loicdrbx/Hydroponics_Kicad/Hydroponics Shield/Hydroponics Shield Rev4/hydroponics_shield_rev4.step

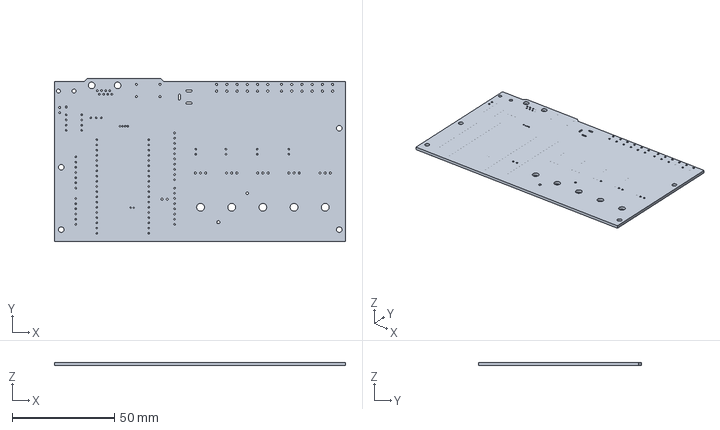
[picture p1: CAD file, 2019-01-07]
Hydroponics Shield/Hydroponics Shield Rev4/hydroponics_shield_rev4.step
142.2 x 79.8 x 1.60 mm
