loicdrbx/Hydroponics_Kicad/Hydroponics Shield/Hydroponics Shield Rev4/hydroponics_shield_rev4.kicad_pcb

## KiCad design Hydroponics Shield/Hydroponics Shield Rev4/hydroponics_shield_rev4.kicad_pcb (2019-01-07)

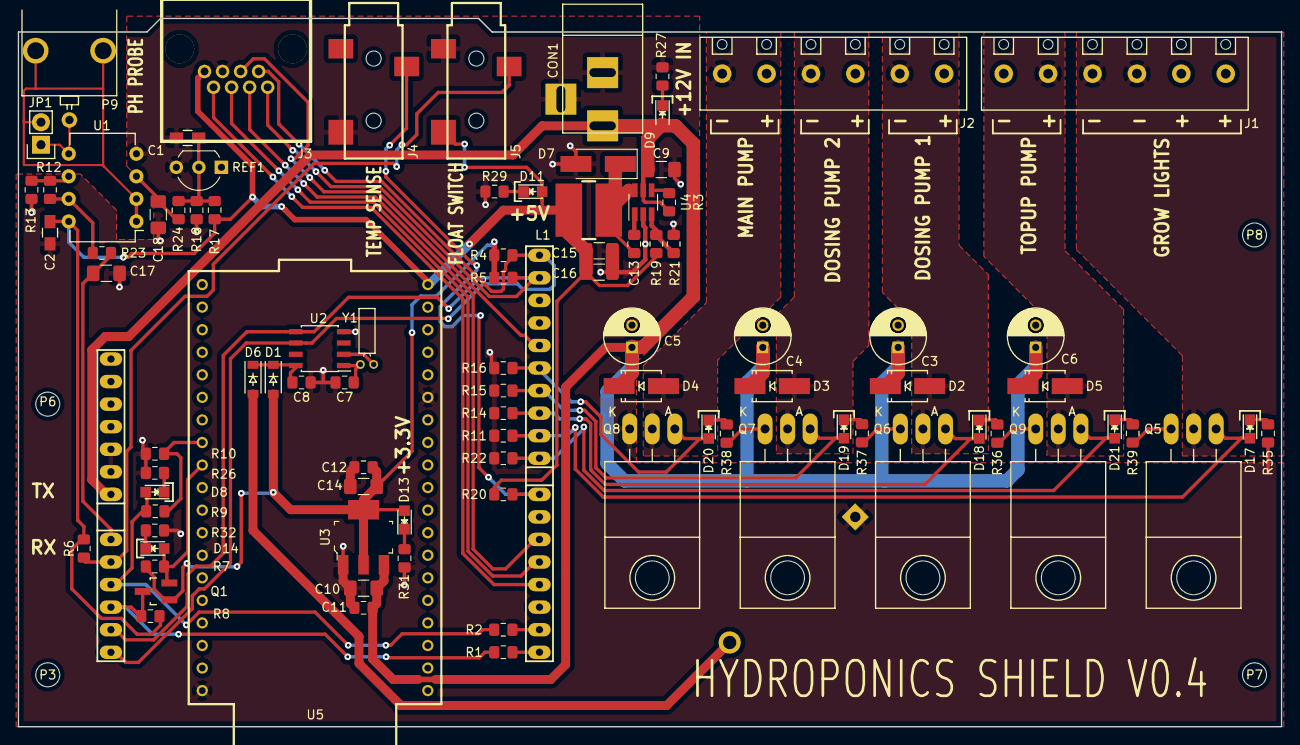
[picture p2: board hydroponics_shield_rev4.kicad_pcb from above]

Board: 2 copper layers, 142.2 x 79.8 mm, 97 parts (1 on the bottom side), 53 nets.

Parts:
BAT1: BS-7_2032; BS-7_USER
C1, C2: 0.1uF; C_0805_HandSoldering
C3, C4, C5, C6: 5ZLH100MEFC6.3X11; C_Radial_D6.3_L11.2_P2.5
C7: 12.5pF NP0; C_0805_2012Metric_Pad1.15x1.40mm_HandSolder
C8, C11, C12: 0.1uF; C_0805_2012Metric_Pad1.15x1.40mm_HandSolder
C9, C10, C14, C15, C16, C17, C18: 4.7uF; C_1206_3216Metric_Pad1.42x1.75mm_HandSolder
C13: 10nF; C_0805_2012Metric_Pad1.15x1.40mm_HandSolder
CON1: PJ-202A; BARREL_JACK
D1, D6: 1N4448W-TP; SOD-123
D2, D3, D4, D5: S1GTR; SMA_Handsoldering
D7: STPS160A; D_SMA_Handsoldering
D8, D9, D11, D13, D14, D17, D18, D19, D20, D21: GN; LED_0805
J1, J2: 282836-6
J3: RJHSE-5080
J4, J5: SJ-3523-SMT-TR
JP1: Jumper_NO_Small; Pin_Header_Straight_1x02
L1: SRN6045-101; SRN6045
P3, P6, P7, P8: MTG; MountingHole_2-7mm
P9: 0731000105
Q1: DMN65D8L-7; SOT-23_Handsoldering
Q5, Q6, Q7, Q8, Q9: PSMN022-30PL,127; TO-220_Neutral123_Horizontal_LargePads
R1, R12: 0; R_0805_2012Metric_Pad1.15x1.40mm_HandSolder
R2, R13, R18: DNP; R_0805_2012Metric_Pad1.15x1.40mm_HandSolder
R3, R7, R8, R9, R10, R11, R14, R15, R16, R20, R22: 10.0k; R_0805_2012Metric_Pad1.15x1.40mm_HandSolder
R4, R5, R27: 1.0k; R_0805_2012Metric_Pad1.15x1.40mm_HandSolder
R6: 4.7k; R_0805_2012Metric_Pad1.15x1.40mm_HandSolder
R17: 10.0k 0.1%; R_0805_2012Metric_Pad1.15x1.40mm_HandSolder
R19, R23, R24: 49.9k; R_0805_2012Metric_Pad1.15x1.40mm_HandSolder
R21: 9.53k; R_0805_2012Metric_Pad1.15x1.40mm_HandSolder
R26, R29, R35, R36, R37, R38, R39: 500; R_0805_2012Metric_Pad1.15x1.40mm_HandSolder
R31, R32: 200; R_0805_2012Metric_Pad1.15x1.40mm_HandSolder
REF1: LT1004CZ-2.5; TO-92_Inline_Wide
SHIELD1: ARDUINO_SHIELD_R3_WI2C
U1: LMC6482IN; DIP-8_W7.62mm
U2: PCF8563T; SOIC-8_3.9x4.9mm_P1.27mm
U3: AZ1117CH-3_3TRG1; SOT-223
U4: AOZ1280CI; SOT-23-6_Handsoldering
U5: ESP32_devkitc; ESP32_DEVKITC
Y1: CFS-20632768DZFB; Crystal_Round_Horizontal_2mm

Connections:
+3V3: C12.1, C14.1, D1.2, D13.2, Q1.1, R4.2, R5.2, R7.2, U3.2, U3.4
+5V: C2.1, C15.1, C16.1, D11.2, J3.1, J5.2, L1.1, R6.2, R8.1, R17.1, R19.2, R20.2, U1.8, U5.5V
+12V: C3.1, C4.1, C5.1, C6.1, C9.1, C10.1, C11.1, CON1.1, D2.1, D3.1, D4.1, D5.1, D9.2, J1.1, J1.2, J1.6, J2.1, J2.3, J2.5, R3.2, SHIELD1.V_IN, U3.3, U4.5
/D1DRV: D2.2, J2.2, Q6.2
/D2DRV: D3.2, J2.4, Q7.2
/LEDDRV: J1.3, J1.4, Q5.2
/MPDRV: D4.2, J2.6, Q8.2
/TPDRV: D5.2, J1.5, Q9.2
BATT_BACKUP: BAT1.2, D6.2
DISPLAY_RESET: J3.5, SHIELD1.13
DOSING_PUMP_1: D18.2, Q6.1, R14.2, SHIELD1.10
DOSING_PUMP_2: D19.2, Q7.1, R15.2, SHIELD1.11
ENCODER_A: J3.2, SHIELD1.3
ENCODER_B: J3.4, SHIELD1.4
ENCODER_SW: J3.6, SHIELD1.5
FLOAT_SWITCH_IN: J4.3, R20.1, SHIELD1.7
GND: BAT1.1, C1.2, C2.2, C3.2, C4.2, C5.2, C6.2, C7.2, C8.1, C9.2, C10.2, C11.2, C12.2, C14.2, C15.2, C16.2, C17.2, C18.2, CON1.2, CON1.3, D7.2, J3.3, J4.2, J5.1, Q5.3, Q6.3, Q7.3, Q8.3, Q9.3, R10.1, R11.1, R13.1, R14.1, R15.1, R16.1, R18.2, R21.1, R22.1, R26.2, R27.2, R29.2, R31.2, R32.2, R35.2, R36.2, R37.2, R38.2, R39.2, REF1.3, SHIELD1.GND1, SHIELD1.GND2, SHIELD1.GND3, U1.4, U2.4, U3.1, U4.2, U5.GND1, U5.GND2, U5.GND3
LED_STRIP_OUT: D17.2, Q5.1, R11.2, SHIELD1.9
MAIN_PUMP: D20.2, Q8.1, R16.2, SHIELD1.12
unnamed: C1.1, R17.2, R18.1, R24.1, REF1.2
unnamed: C7.1, U2.1, Y1.1
unnamed: C8.2, D1.1, D6.1, U2.8
unnamed: C13.1, U4.1
unnamed: C13.2, D7.1, L1.2, U4.6
unnamed: C18.1, R24.2, U1.3
unnamed: D8.1, R26.1
unnamed: D9.1, R27.1
unnamed: D11.1, R29.1
unnamed: D13.1, R31.1
unnamed: D14.1, R32.1
unnamed: D14.2, Q1.2, R7.1, U5.17
unnamed: D17.1, R35.1
unnamed: D18.1, R36.1
unnamed: D19.1, R37.1
unnamed: D20.1, R38.1
unnamed: D21.1, R39.1
unnamed: JP1.1, P9.1, U1.5
unnamed: R1.2, SHIELD1.0
unnamed: R2.2, SHIELD1.1
unnamed: R3.1, U4.4
unnamed: R9.1, R10.2, U5.16
unnamed: R12.1, R13.2, U1.6
unnamed: R12.2, R23.2, U1.7
unnamed: R19.1, R21.2, U4.3
unnamed: U2.2, Y1.2
PH_VOUT: C17.1, R23.1, SHIELD1.AD0
SCL: J3.7, R4.1, SHIELD1.AD5, SHIELD1.SCL, U2.6
SDA: J3.8, R5.1, SHIELD1.AD4, SHIELD1.SDA, U2.5
TEMP_SENSE_IN: J5.3, R6.1, SHIELD1.AD1
TOPUP_PUMP: D21.2, Q9.1, R22.2, SHIELD1.8
Vguard: JP1.2, P9.2, P9.3, U1.1, U1.2
WIFI_DATA_RECEIVE: Q1.3, R1.1, R8.2, SHIELD1.AD3
WIFI_DATA_TRANSMIT: D8.2, R2.1, R9.2, SHIELD1.AD2
