loicdrbx/Hydroponics_Kicad/Controller Board/Controller Board Rev2/controller_board.kicad_pcb

## KiCad design Controller Board/Controller Board Rev2/controller_board.kicad_pcb (2019-01-07)

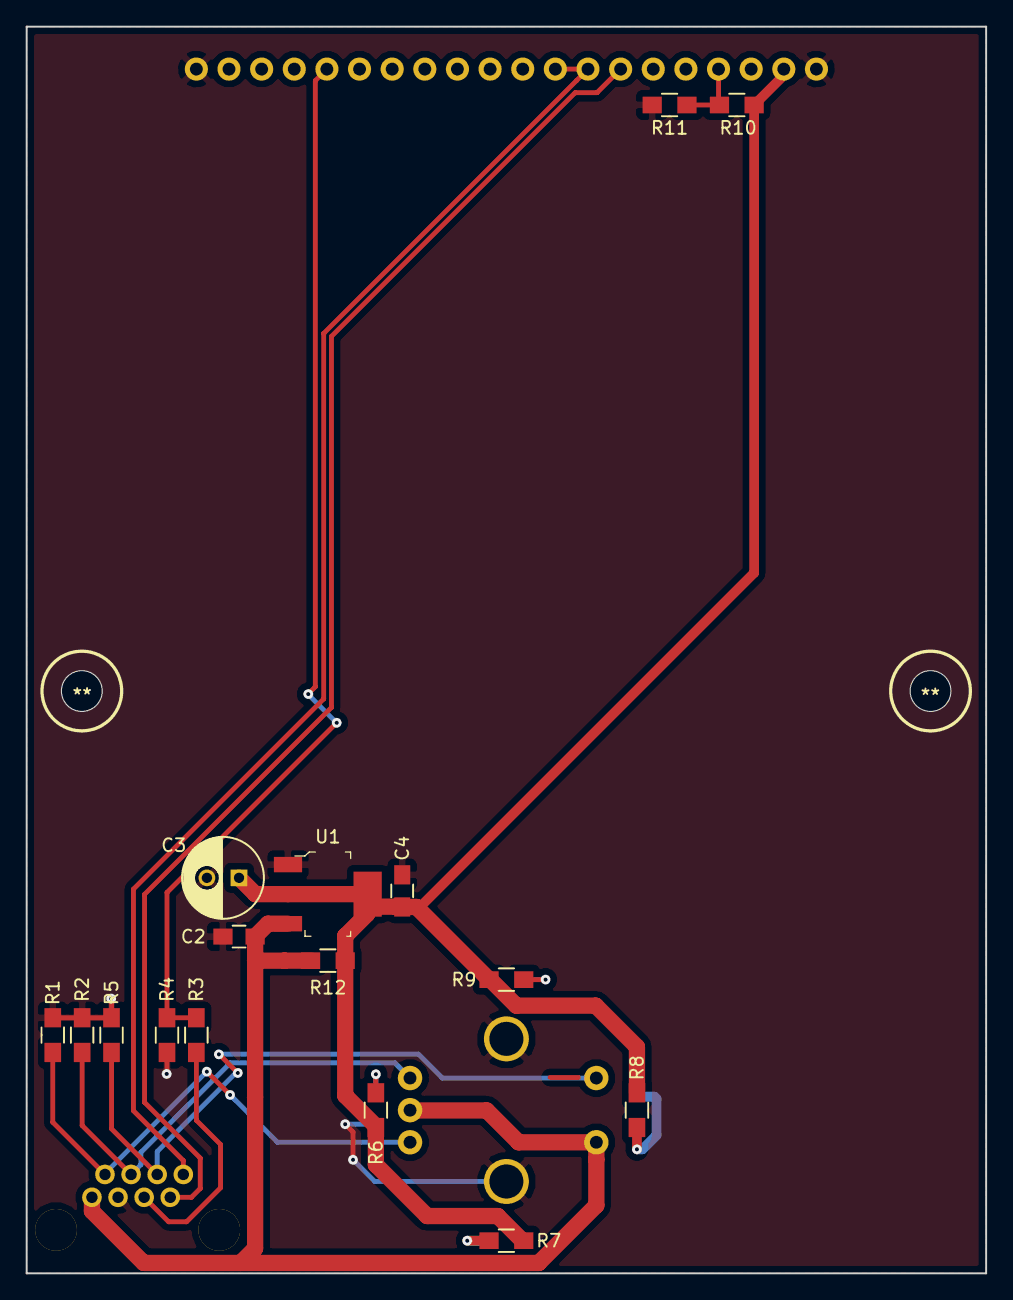
[picture p3: board controller_board.kicad_pcb from above]

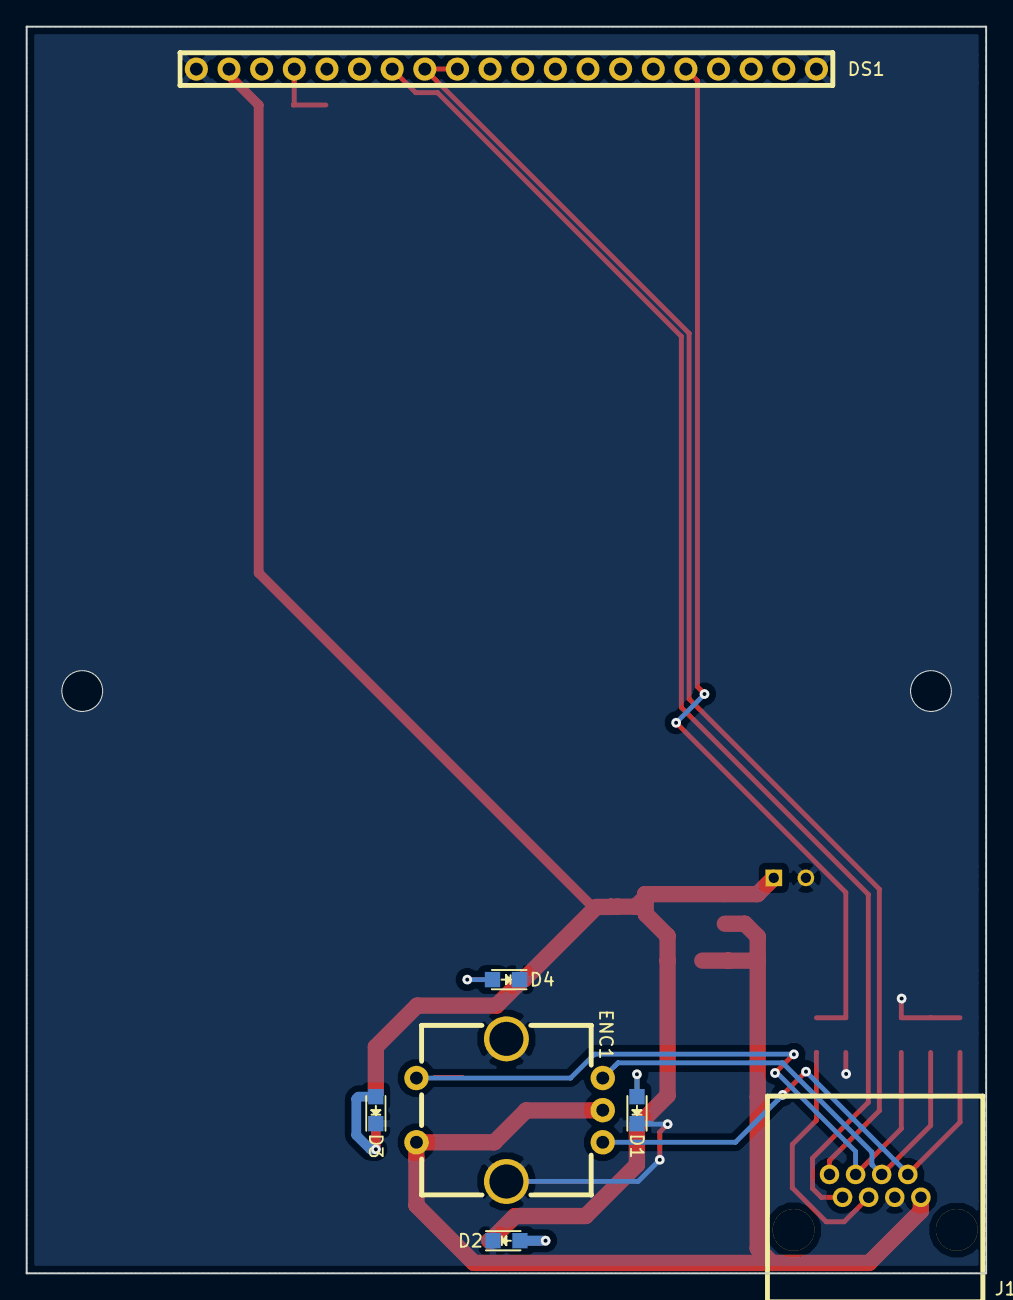
[picture p4: board controller_board.kicad_pcb from below]

Board: 2 copper layers, 74.7 x 97.0 mm, 25 parts (7 on the bottom side), 15 nets.

Parts:
**: MOUNTING_HOLE_0.125in
**#2: MOUNTING_HOLE_0.125in
C2, C4: 0.1uF; C_0805_HandSoldering
C3: 5ZLH100MEFC6.3X11; C_Radial_D6.3_L11.2_P2.5
D1, D2, D3, D4: GRN; LED_0805
DS1: OLED_GENERIC_SSD1305_20PIN_128x64; 128x64_OLED_20PIN_HORIZONTAL
ENC1: EC11K1524406
J1: RJHSE-5080
R1, R2, R3, R4, R5: 10.0k; R_0805_HandSoldering
R6, R7, R8, R9: 120; R_0805_HandSoldering
R10: 0; R_0805_HandSoldering
R11, R12: DNP; R_0805_HandSoldering
U1: AZ1117CH-3_3TRG1; SOT-223

Connections:
+3V3: C3.1, C4.1, DS1.2, R6.1, R7.1, R8.1, R9.1, R10.1, R12.1, U1.2, U1.4
ENCODER_A: ENC1.A, J1.2, R1.1
ENCODER_B: ENC1.B, J1.4, R2.1
ENCODER_SW: ENC1.E, J1.6, R5.1
GND: C2.2, C3.2, C4.2, D1.1, D2.1, D3.1, D4.1, DS1.1, DS1.20, ENC1.MTG1, ENC1.MTG2, J1.3, R1.2, R2.2, R4.2, R5.2, R11.2, U1.1
unnamed: D1.2, R6.2
unnamed: D2.2, R7.2
unnamed: D3.2, R8.2
unnamed: D4.2, R9.2
unnamed: DS1.4, R10.2, R11.1
unnamed: J1.5, R3.1
OLED_RESET: DS1.16, R3.2, R4.1
SCL: DS1.7, J1.7
SDA: DS1.8, DS1.9, J1.8
VCC: C2.1, ENC1.C, ENC1.D, J1.1, R12.2, U1.3
