loicdrbx/Hydroponics_Kicad/Hydroponics Shield/Hydroponics Shield Rev1/hydroponics_shield_rev1.kicad_pcb

## KiCad design Hydroponics Shield/Hydroponics Shield Rev1/hydroponics_shield_rev1.kicad_pcb (2018-05-15, an earlier design)

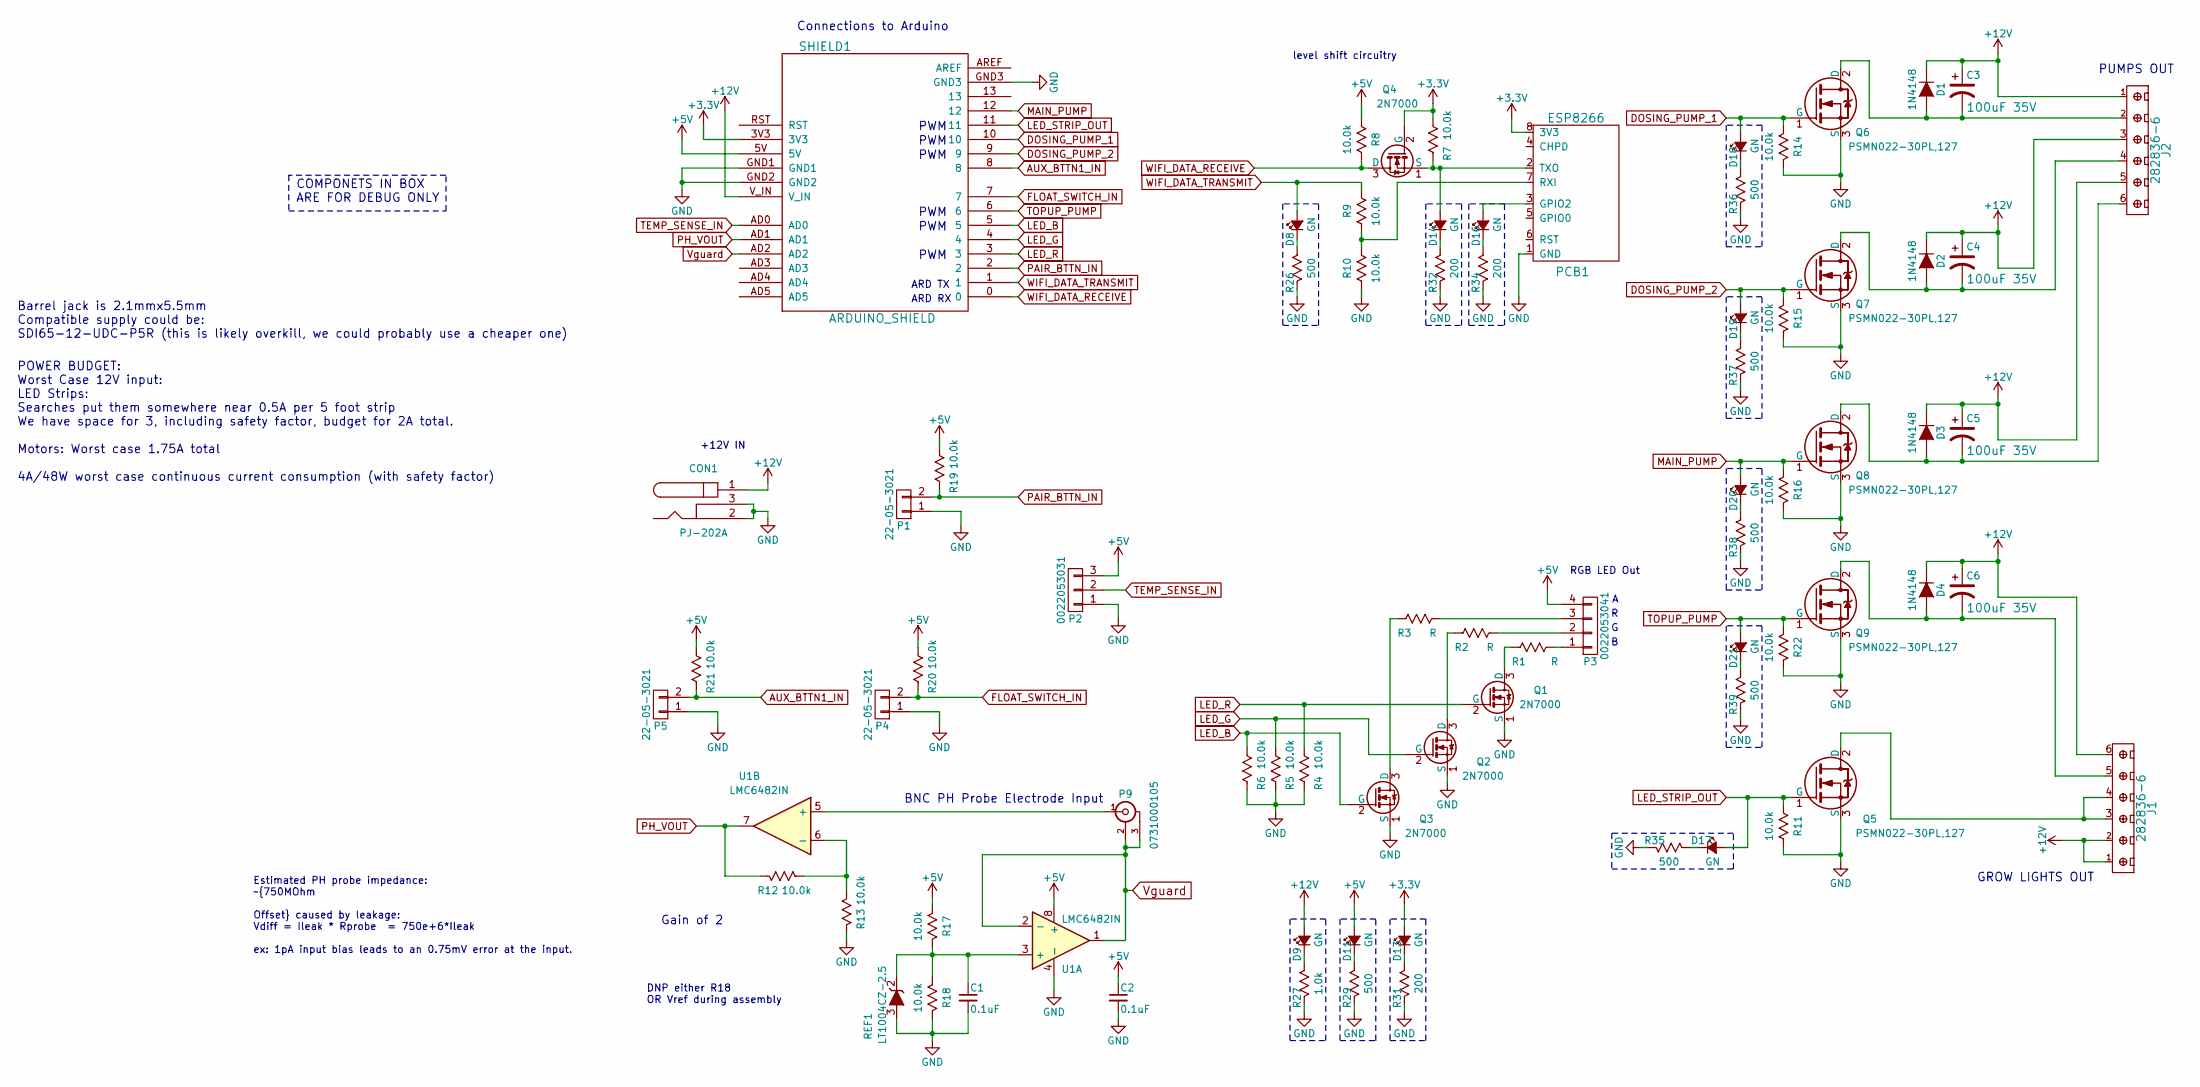
[picture p5: schematic hydroponics_shield_rev1.sch]

Parts:
C1, C2: 0.1uF; C_Disc_D7.5_P5
C3, C4, C5, C6: 5ZLH100MEFC6.3X11; C_Radial_D6.3_L11.2_P2.5
CON1: PJ-202A; BARREL_JACK
D1, D2, D3, D4: 1N4148; Diode_DO-35_SOD27_Horizontal_RM10
D8, D9, D11, D13, D14, D16, D17, D18, D19, D20, D21: GN; LED_0805
J1, J2: 282836-6
P1, P4, P5: 22-05-3021; Pin_Header_Angled_1x02
P2: 0022053031; Pin_Header_Angled_1x03
P3: 0022053041; Pin_Header_Angled_1x04
P9: 0731000105
PCB1: ESP8266
Q1, Q2, Q3, Q4: 2N7000; TO-92_Inline_Wide
Q5, Q6, Q7, Q8, Q9: PSMN022-30PL,127; TO-220_Neutral123_Horizontal_LargePads
R1, R2, R3: R; Resistor_Horizontal_RM10mm
R4, R5, R6, R7, R8, R9, R10, R11, R12, R13, R14, R15, R16, R17, R18, R19, R20, R21, R22: 10.0k; Resistor_Horizontal_RM10mm
R26, R29, R35, R36, R37, R38, R39: 500; R_0805_HandSoldering
R27: 1.0k; R_0805_HandSoldering
R31, R32, R34: 200; R_0805_HandSoldering
REF1: LT1004CZ-2.5; TO-92_Inline_Wide
SHIELD1: ARDUINO_SHIELD; ARDUINO_SHIELD_NOSILK
U1: LMC6482IN; DIP-8_W7.62mm

Connections:
+3V3: D13.2 (A), PCB1.8 (3V3), Q4.2 (G), R7.2, SHIELD1.3V3
+5V: C2.1, D11.2 (A), P2.3, P3.4, R8.1, R17.1, R19.2, R20.2, R21.2, SHIELD1.5V, U1.8 (+)
+12V: C3.1, C4.1, C5.1, C6.1, CON1.1, D1.1 (K), D2.1 (K), D3.1 (K), D4.1 (K), D9.2 (A), J1.1, J1.2, J1.6, J2.1, J2.3, J2.5, SHIELD1.V_IN
AUX_BTTN1_IN: P5.2, R21.1, SHIELD1.8
DOSING_PUMP_1: D18.2 (A), Q6.1 (G), R14.2, SHIELD1.10
DOSING_PUMP_2: D19.2 (A), Q7.1 (G), R15.2, SHIELD1.9
FLOAT_SWITCH_IN: P4.2, R20.1, SHIELD1.7
GND: C1.2, C2.2, CON1.2, CON1.3, P1.1, P2.1, P4.1, P5.1, PCB1.1 (GND), Q1.1 (S), Q2.1 (S), Q3.1 (S), Q5.3 (S), Q6.3 (S), Q7.3 (S), Q8.3 (S), Q9.3 (S), R4.1, R5.1, R6.1, R10.1, R11.1, R13.1, R14.1, R15.1, R16.1, R18.2, R22.1, R26.2, R27.2, R29.2, R31.2, R32.2, R34.2, R35.2, R36.2, R37.2, R38.2, R39.2, REF1.3, SHIELD1.GND1, SHIELD1.GND2, SHIELD1.GND3, U1.4 (-)
LED_B: Q3.2 (G), R6.2, SHIELD1.5
LED_G: Q2.2 (G), R5.2, SHIELD1.4
LED_R: Q1.2 (G), R4.2, SHIELD1.3
LED_STRIP_OUT: D17.2 (A), Q5.1 (G), R11.2, SHIELD1.11
MAIN_PUMP: D20.2 (A), Q8.1 (G), R16.2, SHIELD1.12
unnamed: C1.1, R17.2, R18.1, REF1.2, U1.3 (+)
unnamed: C3.2, D1.2 (A), J2.2, Q6.2 (D)
unnamed: C4.2, D2.2 (A), J2.4, Q7.2 (D)
unnamed: C5.2, D3.2 (A), J2.6, Q8.2 (D)
unnamed: C6.2, D4.2 (A), J1.5, Q9.2 (D)
unnamed: D8.1 (K), R26.1
unnamed: D9.1 (K), R27.1
unnamed: D11.1 (K), R29.1
unnamed: D13.1 (K), R31.1
unnamed: D14.1 (K), R32.1
unnamed: D14.2 (A), PCB1.2 (TXO), Q4.1 (S), R7.1
unnamed: D16.1 (K), R34.1
unnamed: D16.2 (A), PCB1.3 (GPIO2)
unnamed: D17.1 (K), R35.1
unnamed: D18.1 (K), R36.1
unnamed: D19.1 (K), R37.1
unnamed: D20.1 (K), R38.1
unnamed: D21.1 (K), R39.1
unnamed: J1.3, J1.4, Q5.2 (D)
unnamed: P3.1, R1.2
unnamed: P3.2, R2.2
unnamed: P3.3, R3.2
unnamed: P9.1 (IN), U1.5 (+)
unnamed: PCB1.7 (RXI), R9.1, R10.2
unnamed: Q1.3 (D), R1.1
unnamed: Q2.3 (D), R2.1
unnamed: Q3.3 (D), R3.1
unnamed: R12.1, R13.2, U1.6 (-)
PAIR_BTTN_IN: P1.2, R19.1, SHIELD1.2
PH_VOUT: R12.2, SHIELD1.AD1, U1.7
TEMP_SENSE_IN: P2.2, SHIELD1.AD0
TOPUP_PUMP: D21.2 (A), Q9.1 (G), R22.2, SHIELD1.6
Vguard: P9.2 (SHIELD1), P9.3 (SHIELD2), SHIELD1.AD2, U1.1, U1.2 (-)
WIFI_DATA_RECEIVE: Q4.3 (D), R8.2, SHIELD1.0
WIFI_DATA_TRANSMIT: D8.2 (A), R9.2, SHIELD1.1

Notes on the sheet:
Connections to Arduino
BNC PH Probe Electrode Input
+12V IN
RGB LED Out
ARD TX
ARD RX
level shift circuitry
Estimated PH probe impedance: ~750MOhm Offset caused by leakage: Vdiff = Ileak * Rprobe = 750e+6*Ileak ex: 1pA input bias leads to an 0.75mV error at the input.
DNP either R18 OR Vref during assembly
GROW LIGHTS OUT
PUMPS OUT
Gain of 2
PWM
POWER BUDGET: Worst Case 12V input: LED Strips: Searches put them somewhere near 0.5A per 5 foot strip We have space for 3, including safety factor, budget for 2A total. Motors: Worst case 1.75A total 4A/48W worst case continuous current consumption (with safety factor)
Barrel jack is 2.1mmx5.5mm Compatible supply could be: SDI65-12-UDC-P5R (this is likely overkill, we could probably use a cheaper one)
COMPONETS IN BOX ARE FOR DEBUG ONLY

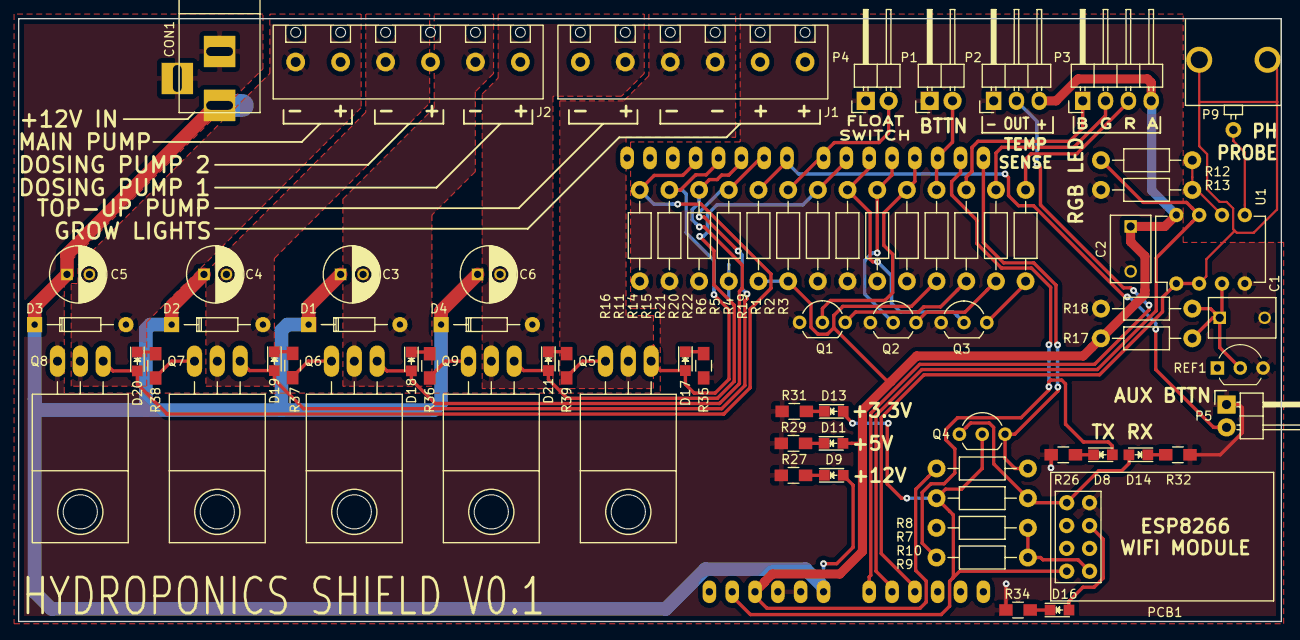
[picture p6: board hydroponics_shield_rev1.kicad_pcb from above]

Board: 2 copper layers, 140.5 x 67.1 mm, 76 parts (0 on the bottom side), 48 nets.
