loicdrbx/Hydroponics_Kicad/(commit log)

2018-05-04 desktop night changes
    [hydroponics_shield_rev1.kicad_pcb, hydroponics_shield_rev1.sch]
2018-05-04 workday additions
    [hydroponics_shield_rev1.kicad_pcb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]
2018-05-08 changes made extra pump wifi
    [hydroponics_shield_rev1.kicad_pcb, hydroponics_shield_rev1.sch]
2018-05-09 finished board change from bt to wifi
    [hydroponics_shield_rev1.kicad_pcb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]
2018-05-26 version 2 PCB redesign
    [hydroponics_shield_rev1-B.Cu.gbr, hydroponics_shield_rev1-B.Mask.gbr, hydroponics_shield_rev1-B.SilkS.gbr, hydroponics_shield_rev1-Edge.Cuts.gbr, hydroponics_shield_rev1-F.Cu.gbr, hydroponics_shield_rev1-F.Mask.gbr, hydroponics_shield_rev1-F.SilkS.gbr, hydroponics_shield_rev1-NPTH.drl]
2018-08-10 for Loic
    [hydroponics_shield_rev2.kicad_pcb]
2018-08-20 finished new rev3 board
    [controller_board.csv, controller_board.kicad_pcb, controller_board.ods, controller_board.sch, controller_board.xlsx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]
2018-12-19 Long overdue
    [controller_board-2018-09-28-13-52-58.sch, controller_board.kicad_pcb, controller_board.sch, controller_board.xlsx, hydroponics_shield_rev3.ods, hydroponics_shield_rev3.xlsx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]
